Endres/meshlight/kicad/meshlight.kicad_pcb

## KiCad design kicad/meshlight.kicad_pcb (2020-01-27)

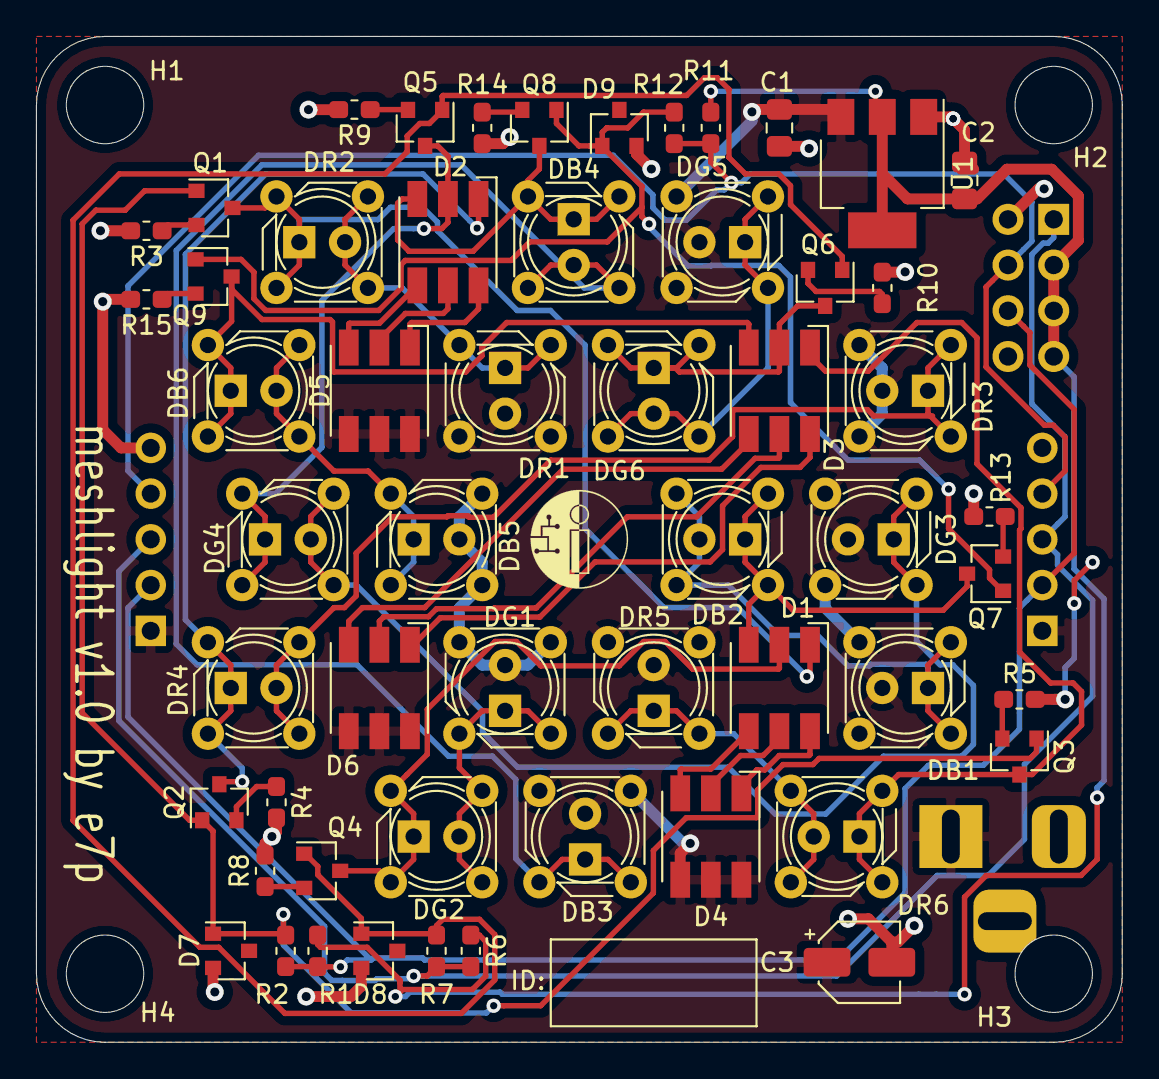
[picture p1: board meshlight.kicad_pcb from above]

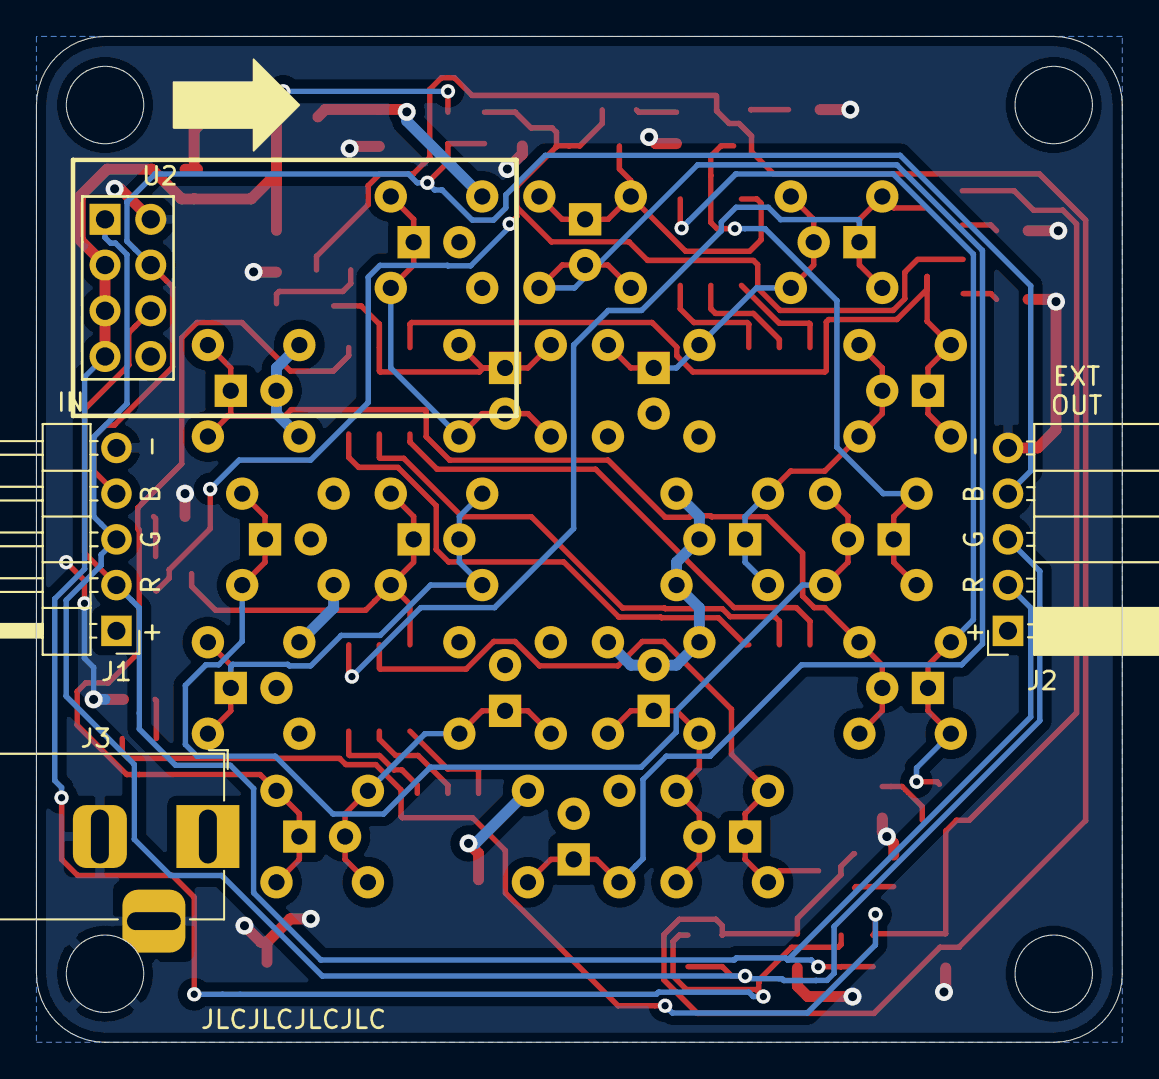
[picture p2: board meshlight.kicad_pcb from below]

Board: 2 copper layers, 60.3 x 55.9 mm, 63 parts (4 on the bottom side), 45 nets.

Parts:
C1, C2: 4u7; C_0805_2012Metric_Pad1.15x1.40mm_HandSolder
C3: 10u; CP_Elec_4x5.4
D1, D2, D3, D4, D5, D6: LED_RGB; LED_RGB_5050-6
D7, D8, D9: BAV99; SOT-23
DB1, DB2, DB3, DB4, DB5, DB6: LED; LED_SuperFlux_5x5_4pin_D5.00mm_combi
DG1, DG2, DG3, DG4, DG5, DG6: LED; LED_SuperFlux_5x5_4pin_D5.00mm_combi
DR1, DR2, DR3, DR4, DR5, DR6: LED; LED_SuperFlux_5x5_4pin_D5.00mm_combi
H1, H2, H4: MountingHole; MountingHole_4.3mm_M4
H3: MountingHole_Pad; MountingHole_4.3mm_M4
J1: Conn_01x05_Male; PinHeader_1x05_P2.54mm_Horizontal
J2: Conn_01x05_Female; PinSocket_1x05_P2.54mm_Horizontal
J3: Barrel_Jack_Switch; BarrelJack_Horizontal
Q1, Q2, Q3, Q4, Q5, Q6, Q7, Q8, Q9: BC847; SOT-23
R1, R6, R11: 10k; R_0603_1608Metric_Pad1.05x0.95mm_HandSolder
R2, R7, R12: 1k; R_0603_1608Metric_Pad1.05x0.95mm_HandSolder
R3, R4, R5, R8, R9, R10, R13, R14, R15: 42R2; R_0603_1608Metric_Pad1.05x0.95mm_HandSolder
U1: AP1117-33; SOT-223-3_TabPin2
U2: ESP-01v090; ESP-01

Connections:
+3V3: C2.1, R1.1, R6.1, R11.1, U1.2, U2.3, U2.5, U2.7
+7.5V: C1.2, C3.1, D4.4, D4.5, D4.6, D5.4, D5.5, D5.6, D6.4, D6.5, D6.6, DB1.2, DB3.2, DB5.2, DG1.2, DG3.2, DG5.2, DR1.2, DR3.2, DR5.2, J1.1, J2.1, J3.1, U1.3
/LB1: D1.3, DB2.1, Q7.3
/LB2: D2.3, DB4.1, Q8.3
/LB3: D3.3, DB6.1, Q9.3
/LED_B: J1.4, J2.4, R11.2, R12.1, U2.4
/LED_G: J1.3, J2.3, R6.2, R7.1, U2.1
/LED_R: J1.2, J2.2, R1.2, R2.1, U2.6
/LG1: D1.2, DG2.1, Q4.3
/LG2: D2.2, DG4.1, Q5.3
/LG3: D3.2, DG6.1, Q6.3
/LR1: D1.1, DR2.1, Q1.3
/LR2: D2.1, DR4.1, Q2.3
/LR3: D3.1, DR6.1, Q3.3
GND: C1.1, C2.2, C3.2, D7.2, D8.2, D9.2, H3.1, J1.5, J2.5, J3.2, J3.3, R3.2, R4.2, R5.2, R8.2, R9.2, R10.2, R13.2, R14.2, R15.2, U1.1, U2.2
unnamed: D1.4, D4.3
unnamed: D1.5, D4.2
unnamed: D1.6, D4.1
unnamed: D2.4, D5.3
unnamed: D2.5, D5.2
unnamed: D2.6, D5.1
unnamed: D3.4, D6.3
unnamed: D3.5, D6.2
unnamed: D3.6, D6.1
unnamed: D7.1, Q1.1, Q2.1, Q3.1, R2.2
unnamed: D8.1, Q4.1, Q5.1, Q6.1, R7.2
unnamed: D9.1, Q7.1, Q8.1, Q9.1, R12.2
unnamed: DB1.1, DB2.2
unnamed: DB3.1, DB4.2
unnamed: DB5.1, DB6.2
unnamed: DG1.1, DG2.2
unnamed: DG3.1, DG4.2
unnamed: DG5.1, DG6.2
unnamed: DR1.1, DR2.2
unnamed: DR3.1, DR4.2
unnamed: DR5.1, DR6.2
unnamed: Q1.2, R3.1
unnamed: Q2.2, R4.1
unnamed: Q3.2, R5.1
unnamed: Q4.2, R8.1
unnamed: Q5.2, R9.1
unnamed: Q6.2, R10.1
unnamed: Q7.2, R13.1
unnamed: Q8.2, R14.1
unnamed: Q9.2, R15.1
