Endres/meshlight/(commit log)

2020-01-24 First Schematic Draft
    [meshlight.kicad_pcb, meshlight.sch]
2020-01-24 adding white LED channel
    [meshlight.sch]
2020-01-25 removed the white channel again, but added 6-pin RGB LEDs as an alternative and connectors for expanding multiple PCBs
    [meshlight.sch]
2020-01-25 fixed ERC bugs
    [meshlight.sch]
2020-01-26 first placement idea of leds
    [meshlight.kicad_pcb, meshlight.sch]
2020-01-26 basic rough placing of all components
    [meshlight.kicad_pcb]
2020-01-26 routed pcb
    [meshlight.kicad_pcb, meshlight.sch]
2020-01-27 added gerber files for fab
    [meshlight-B_Cu.gbr, meshlight-B_Mask.gbr, meshlight-B_SilkS.gbr, meshlight-Edge_Cuts.gbr, meshlight-F_Cu.gbr, meshlight-F_Mask.gbr, meshlight-F_SilkS.gbr, meshlight-NPTH.drl]
2020-01-27 add notes for led selection
2020-02-05 simple UDP implementation (however currently without mesh because of problems)
    [arduino.ino]
2020-02-11 current animation framework state, has to be improved
2020-02-11 current state of frontend template and some notes
2020-02-27 let the frontend receive the current mode as well
2020-03-02 add global blackout switch
2020-03-04 fix bug in arduino code
    [arduino.ino]
